ward208k/CS207_Project/images/3%4 View.jpg

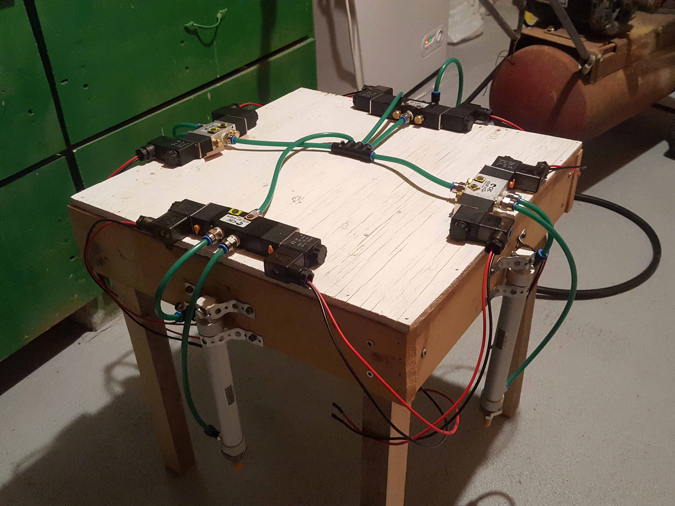
images/3%4 View.jpg
