ward208k/CS207_Project/images/Arduino.jpg

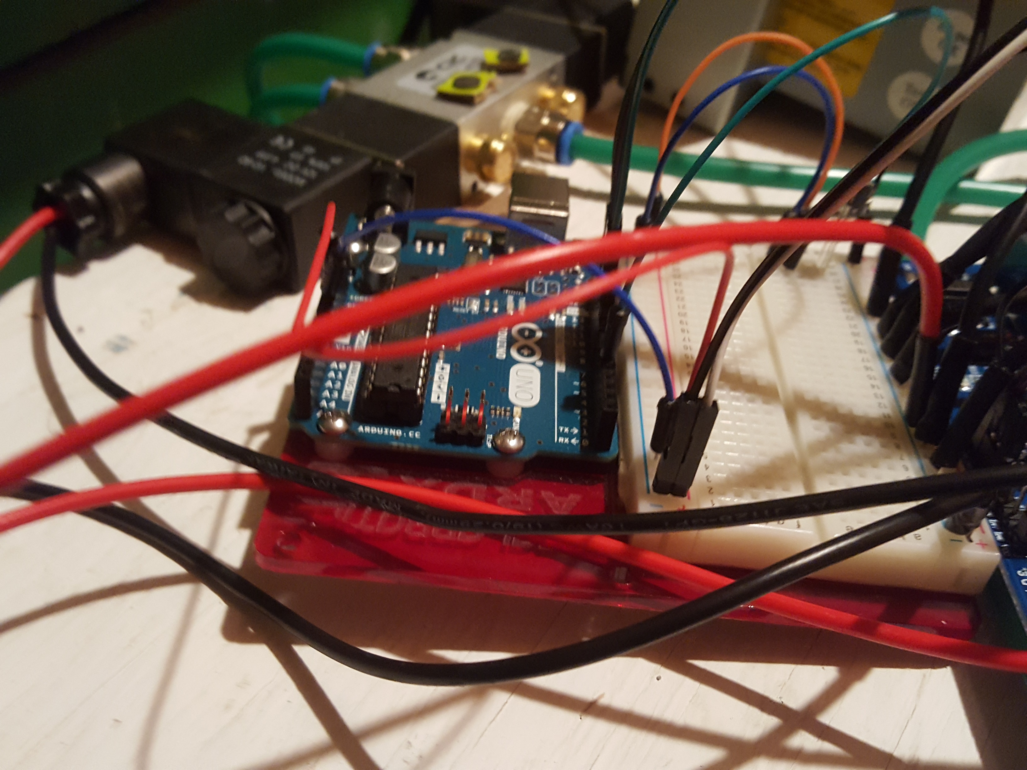
images/Arduino.jpg
