ward208k/CS207_Project/images/Leg View.jpg

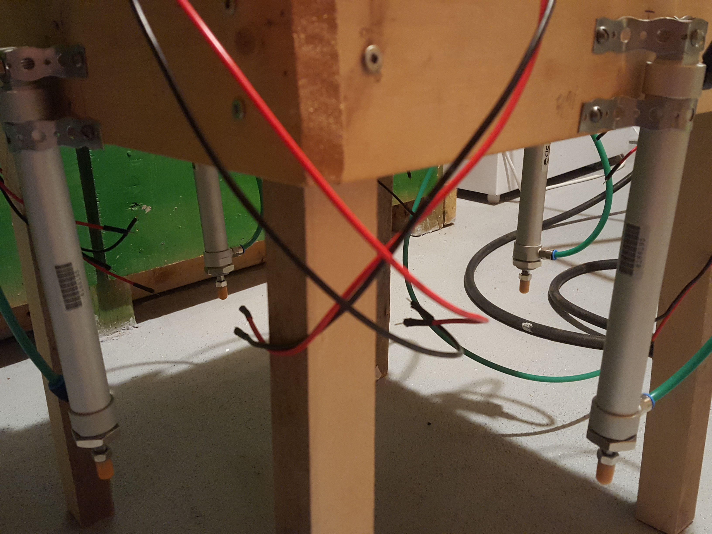
images/Leg View.jpg
