ward208k/CS207_Project/images/Power Supply.jpg

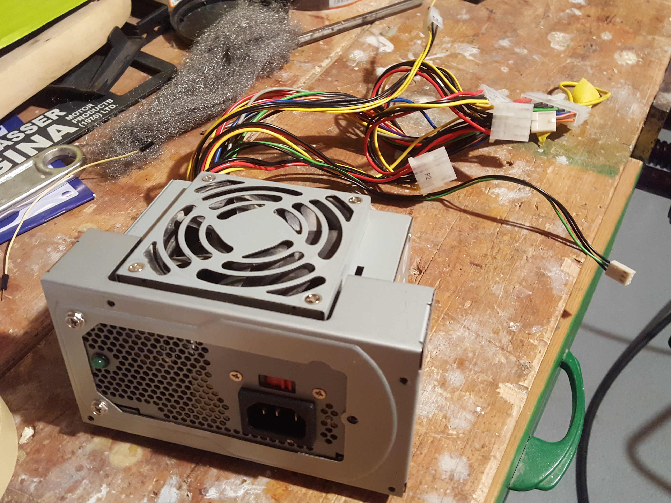
images/Power Supply.jpg
