ward208k/CS207_Project/images/Power.jpg

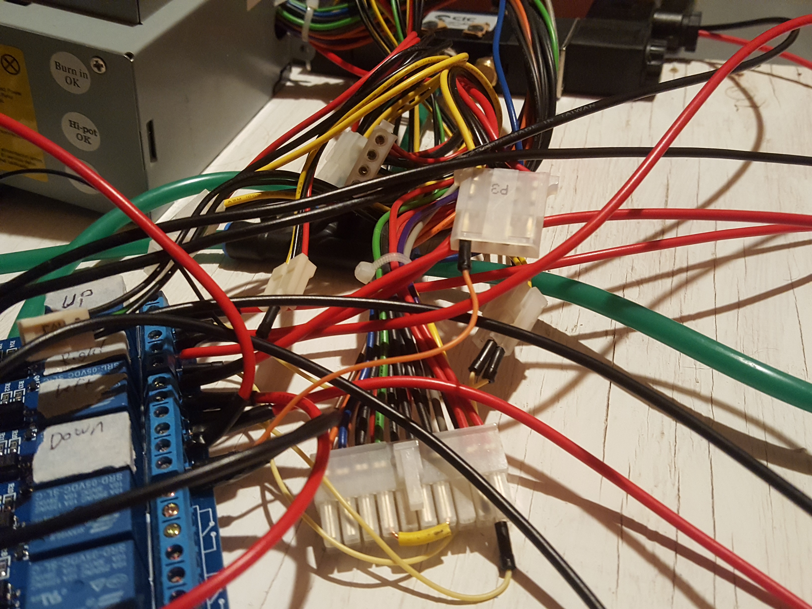
images/Power.jpg
