ward208k/CS207_Project/images/Remote.jpg

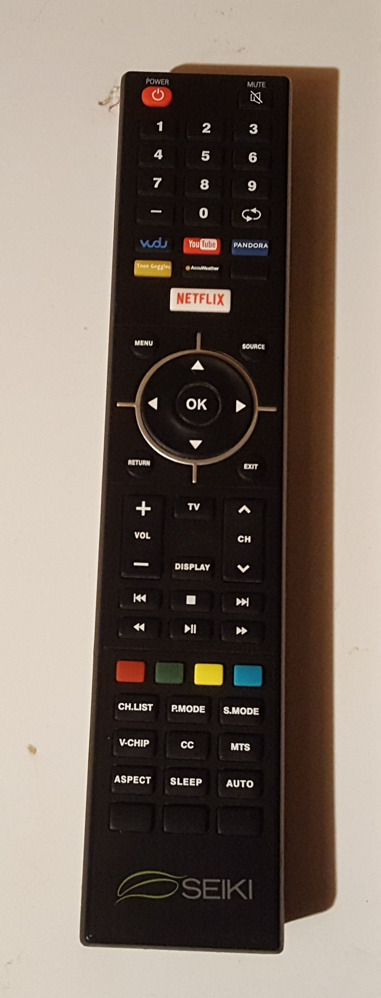
images/Remote.jpg
