ward208k/CS207_Project/images/Wires.jpg

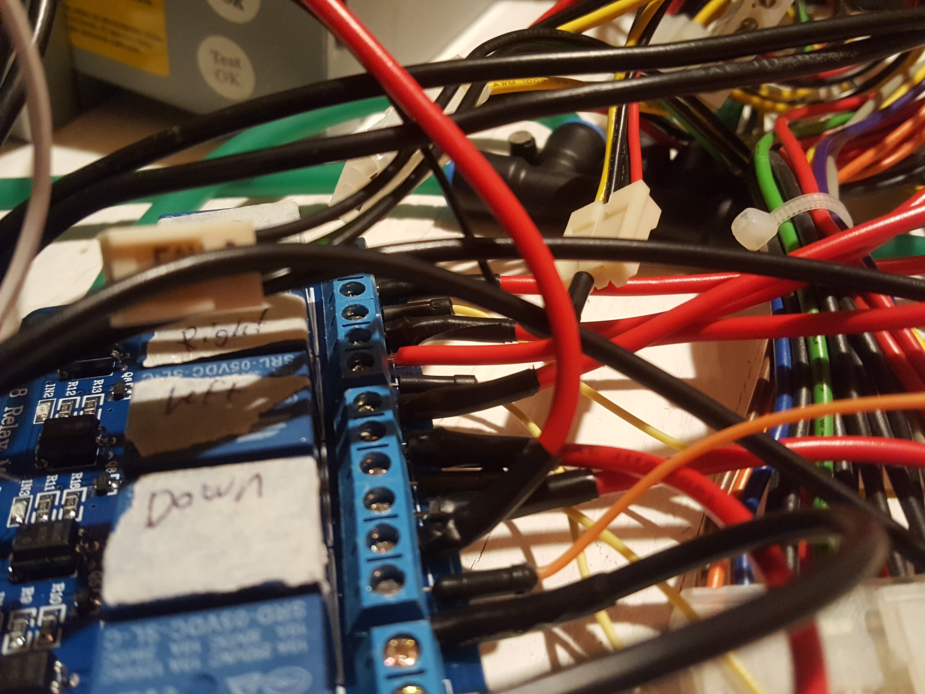
images/Wires.jpg
