ward208k/CS207_Project/(commit log)

2017-02-26 Added V2.0 part list
    Added list of parts for version 2.0, the air and buttons
2017-02-26 Added wiring video
    Embedded a video of how to wire a solenoid valve. Very helpful
2017-03-28 Build 2.0 info added and updated
    Added instruction on how to build the body and valve system.
2017-03-28 Added the power supply spec sheet
    Added computer power supply ATX sheet for everyone to use
2017-03-28 Added V2.0 usage
    Added the usage instructions for the valve tests and set up.
2017-03-28 Update README.md
    Added diagrams of the valves to the usage
2017-03-28 Added V2.0 Images
    Added valve diagram images
2017-03-29 Added V2 sketch
    added V2 sketch so that one can upload it to their arduino
2017-04-03 Added image links
    Added image links to from the image folder for Arduino set up and final set up
